crimpdeq/crimpdeq-grips/docs/src/SUMMARY.md

# Summary

[Introduction](introduction.md)

# Photon

- [Fit to your hand](photon/fit.md)
- [Printing](photon/printing.md)
- [Parts](photon/parts.md)
- [Assembly](photon/assembly.md)

# Spark

- [Fit to your hand](spark/fit.md)
- [Printing](spark/printing.md)
- [Parts](spark/parts.md)
- [Assembly](spark/assembly.md)

# Mico

- [Size and cord](mico/size.md)
- [Printing](mico/printing.md)

# Quark

- [Pinches and cord](quark/pinches.md)
- [Printing](quark/printing.md)

# Development

- [Models and checks](development.md)
