crimpdeq/crimpdeq-grips/docs/src/spark/images/end_wall.png

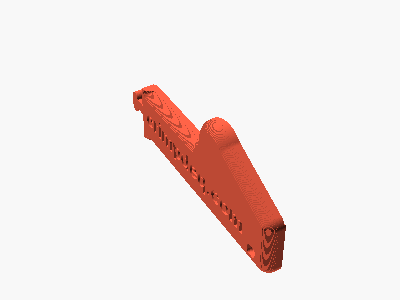
docs/src/spark/images/end_wall.png
