crimpdeq/crimpdeq-grips/docs/src/spark/images/frame.png

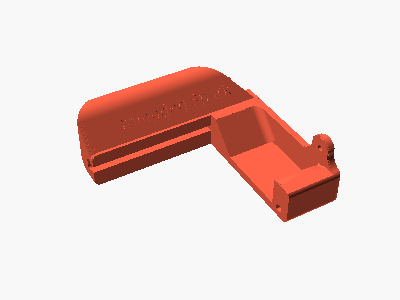
docs/src/spark/images/frame.png
