crimpdeq/crimpdeq-grips/docs/src/spark/images/index_roller.png

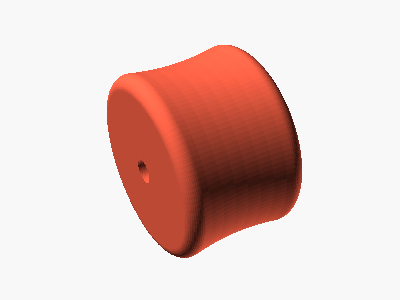
docs/src/spark/images/index_roller.png
