crimpdeq/crimpdeq-grips/docs/src/spark/images/index_wall.png

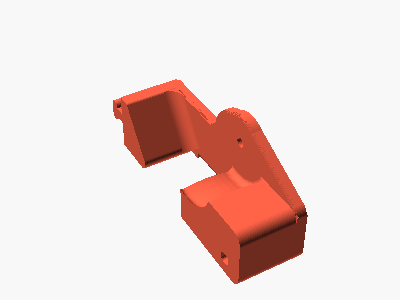
docs/src/spark/images/index_wall.png
