crimpdeq/crimpdeq-grips/docs/src/spark/images/middle_pin.png

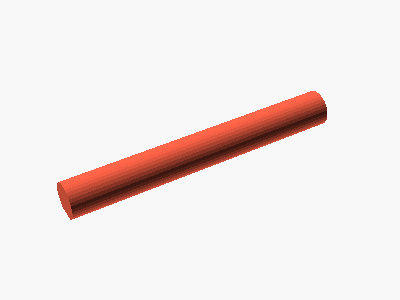
docs/src/spark/images/middle_pin.png
