crimpdeq/crimpdeq-grips/docs/src/spark/images/pinky_roller.png

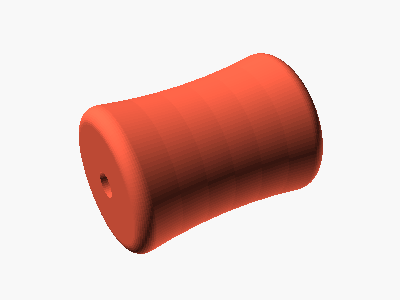
docs/src/spark/images/pinky_roller.png
