crimpdeq/crimpdeq-grips/docs/src/spark/images/ring_wall.png

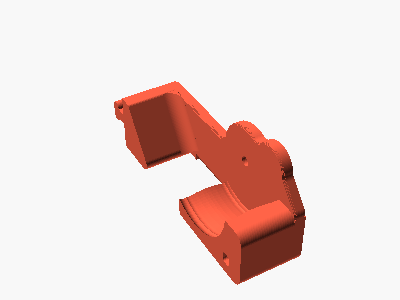
docs/src/spark/images/ring_wall.png
