crimpdeq/crimpdeq-grips/docs/src/photon/parts.md

# Parts

How to put together a printed Photon grip. The pictures show the right-hand grip at the
model's defaults; a left-hand grip is its mirror image and goes together the same way.

You need the 14 printed parts, a cord for the anchor, a mallet or hammer with a small wood block,
and optionally an inert lubricant such as Super Lube.

The middle and index walls look alike: label them as you take them off the plate (the slicer's
object list names every part).

| Part | | How to recognize it |
|---|---|---|
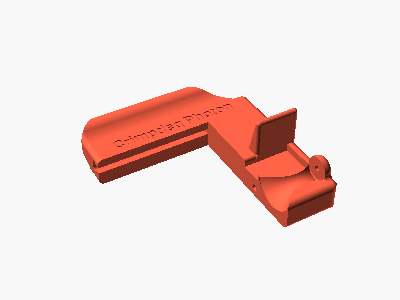
[picture p11: docs/src/photon/images/frame.png]
Frame
| Frame |  | The largest part, with the top crossbar engraved `Crimpdeq Photon` and the cord hole |
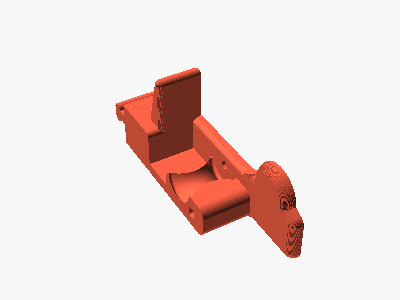
[picture p12: docs/src/photon/images/ring_wall.png]
Ring wall
| Ring wall |  | Round hump around a pin hole |
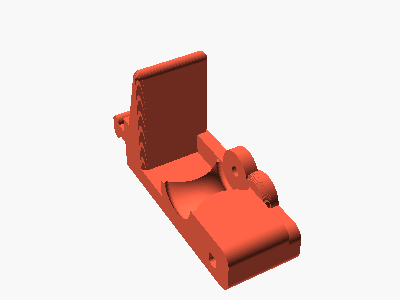
[picture p13: docs/src/photon/images/middle_wall.png]
Middle wall
| Middle wall |  | Looks like the index wall |
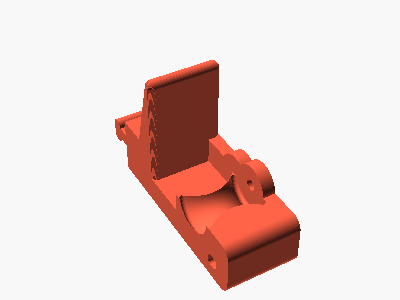
[picture p14: docs/src/photon/images/index_wall.png]
Index wall
| Index wall |  | Looks like the middle wall |
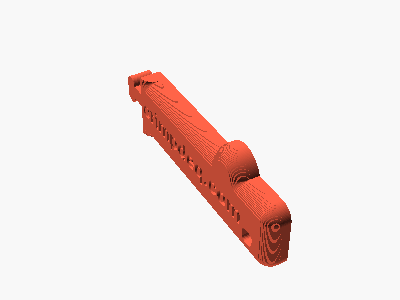
[picture p15: docs/src/photon/images/end_wall.png]
End wall
| End wall |  | Thin plate engraved `crimpdeq.com` |
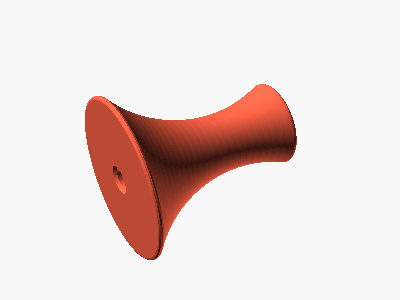
[picture p16: docs/src/photon/images/pinky_roller.png]
Pinky roller
| Pinky roller |  | 30 mm, one narrow and one wide end |
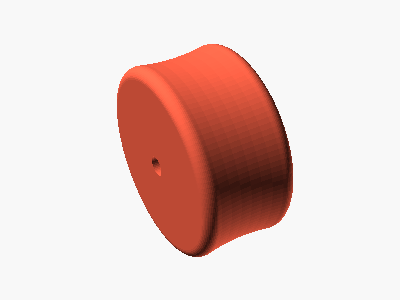
[picture p17: docs/src/spark/images/ring_roller.png]
Roller
| Ring, middle and index rollers (3) |  | 19 mm, both ends the same |
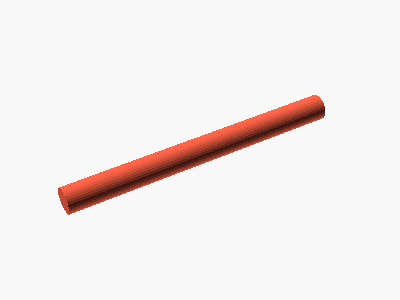
[picture p18: docs/src/photon/images/pinky_pin.png]
Pinky pin
| Pinky pin |  | The longer pin, about 36 mm |
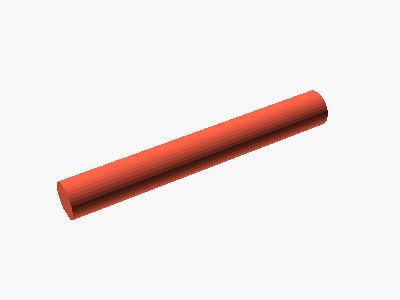
[picture p19: docs/src/photon/images/ring_pin.png]
Pin
| Ring, middle and index pins (3) |  | About 25 mm, interchangeable |
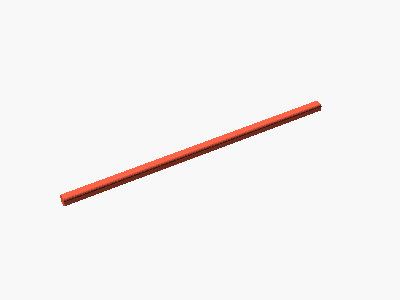
[picture p20: docs/src/spark/images/post.png]
Post
| Post |  | Long square bar, about 105 mm, one corner chamfered |

The illustrations come from the OpenSCAD model; regenerate them with `docs/illustrations/render.sh`.
