crimpdeq/crimpdeq-grips/docs/illustrations/grips.scad

// Both finished grips side by side, Photon on the left, from the STLs of
// ../../scripts/export.py --in-place; render.sh sets stl to their directory, which also holds per
// grip its name engraving's cut (part "name") and its frame without the name: their intersection
// fills the engraving in, in a color of its own.

stl = "/tmp/";

ROLLERS = ["pinky_roller", "ring_roller", "middle_roller", "index_roller"];
BODY = ["frame", "ring_wall", "middle_wall", "index_wall", "end_wall", "pinky_pin", "ring_pin", "middle_pin",
  "index_pin", "post"];

module grip(name) {
  // Near black: pure black hides the shading.
  color([0.16, 0.16, 0.16]) for (p = BODY) import(str(stl, name, "_right_", p, ".stl"));
  color("red") for (p = ROLLERS) import(str(stl, name, "_right_", p, ".stl"));
  color("white") intersection() {
    import(str(stl, name, "_right_name.stl"));
    import(str(stl, name, "_right_unnamed_frame.stl"));
  }
}

grip("photon");
translate([125, 0, 0]) grip("spark");
