crimpdeq/crimpdeq-grips/(list of files, cad)

Other CAD files:
grips/prometheus.scad
grips/spark.scad
docs/illustrations/photon.scad
docs/illustrations/prometheus.scad
