crimpdeq/crimpdeq-grips/docs/src/photon/images/step-4.png

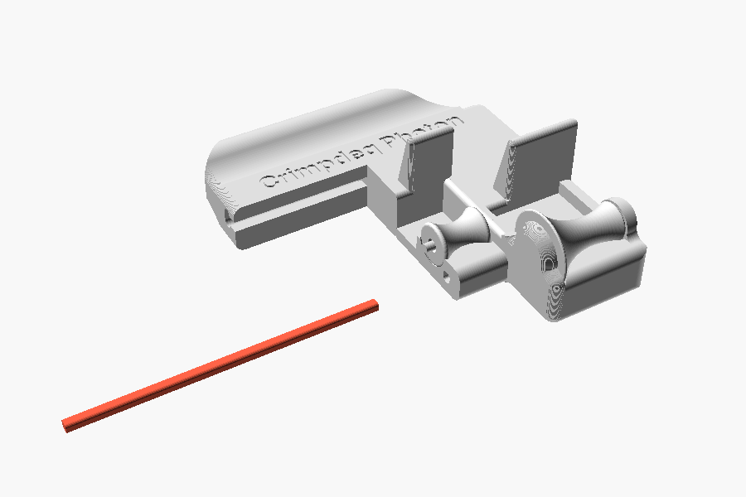
docs/src/photon/images/step-4.png
