crimpdeq/crimpdeq-grips/docs/src/photon/images/step-7.png

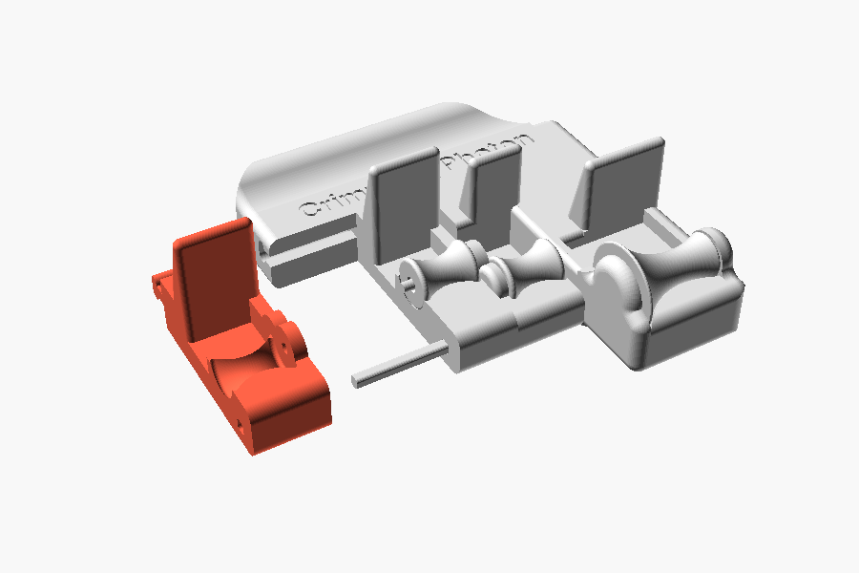
docs/src/photon/images/step-7.png
