crimpdeq/crimpdeq-grips/(commit log)

2026-10-12 feat: add Prometheus hand fitting tools
    prometheus-fit/ measures a hand from a photo (measure-hand.html) and
    generates fitted, print-ready STLs from the original parametric FreeCAD
    model (generate.py), with printed pins sized like the v43 pins. Includes
    a right-hand example with its Bambu Lab A1 project. The root README only
    links to it so the fork's files stay untouched.
2026-10-12 feat: add parametric OpenSCAD model of Prometheus v43
    openscad/prometheus.scad rebuilds every part of the fork's v43 STEP
    (frame, walls, end wall, rollers, printed pins, post and TPU guard)
    from the original FreeCAD VarSet parameters, so measure-hand.html
    output applies unchanged. Each part exports in its print pose, left
    or right hand.
    At v43's blocker positions (the defaults) and frame height, every part
    matches the STEP within 0.3% volume and 0.25 mm at the 99th
    percentile of surface deviation.
2026-10-12 refactor: move shared OpenSCAD building blocks to common.scad
    Extrusion and rounding helpers, pins, post, lock slot and the bore exit
    round move out of prometheus.scad so the Sisyphus model can reuse them.
    Parts are now dispatched from a table, and a blocker reaching the
    crossbar fails with a message instead of breaking the frame.
    All parts still match the v43 STEP as before.
2026-10-12 fix: round OpenSCAD edges without coincident faces
    The rounded end of along_x_rounded now has a core the sharp part ends
    inside, so the two share no faces; thin parts rounded on both faces
    were coming out non-manifold. The bore exit round crosses the faces it
    rounds instead of touching them, which left slivers. Prometheus' anchor
    web joints are rounded as in v43; the round was being overwritten.
2026-10-12 feat: add parametric OpenSCAD model of Sisyphus v27
    openscad/sisyphus.scad rebuilds every part of the fork's Sisyphus v27
    STEP from the original Sisyphus VarSet parameters (heights, seat
    blockers, roller sizes, frame length), exported in print pose for
    either hand. Features the original model lacks (finger stops, anchor,
    guard outline) keep v27's dimensions.
    At the defaults every part matches the STEP within 0.7% volume and,
    except the TPU guard (0.5 mm), 0.1 mm at the 95th percentile.
2026-10-12 feat: add OpenSCAD export and STEP comparison scripts
    export.py writes every part of one hand, optionally from a params.txt
    as measure-hand.html produces it; check_step.py compares each part with
    the STEP solid it rebuilds and fails beyond 1% volume or 0.6 mm at p95.
2026-10-12 docs: document the OpenSCAD models
    openscad/README.md covers use, parameters, printing and how faithful
    the models are; the root and prometheus-fit READMEs link to it and
    AGENTS.md records the model facts and checks for future changes.
2026-10-12 feat: drop the TPU guard from the OpenSCAD models
    Every remaining part prints in one material; the cord through the
    anchor is the only non-printed item. The guard carried no load and the
    anchor's cord exits are already rounded, so the frame works without it.
    The frame's cord switch, which only shaped the guard, goes with it.
2026-10-12 docs: add illustrated Prometheus assembly book
2026-10-12 fix: add a brim to the Prometheus finger walls
2026-10-12 docs: follow the original OpenGrips assembly instructions
2026-10-12 feat: attach Bambu Lab A1 projects to releases
2026-10-13 Download fitted Photon and Spark STLs from the measuring page (#3)
    * perf: round edges with offset layers instead of minkowski()
    minkowski() of non-convex solids needs CGAL, which fails in WebAssembly OpenSCAD and falls back to Nef (13 minutes for one Spark wall). along_x_ball_swept() builds the same ball-swept extrusions from offset profiles in 0.2 mm layers: every part renders in seconds there, native exports get faster, and check_step.py stays within its limits.
    * feat: download fitted Photon and Spark STLs from the measuring page
    The measuring page renders every part with the official WebAssembly OpenSCAD in web workers and downloads a zip per selection: Photon, Spark or both, for one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
2026-10-13 docs: add the Spark chapters and rework the introduction (#6)
    * docs: note that fit chapter is optional for printing the zip
    * docs: add the Spark chapters and rework the introduction
2026-10-20 feat: add Mico, a one-piece mono training loop (#10)
    * feat: add Mico, a one-piece mono training loop
    grips/mico.scad: a 25 mm high loop with a Ø22 finger hole (Hole_Diameter)
    and a cord bore across its flat-ended nose, engraved "Crimpdeq Mico" in
    two arcs on the top face and "crimpdeq.com" around the back, in Inter Bold.
    * feat: release Mico and document it in the book
    export.py exports Mico (mico.stl, no hand), export_bambu_project.py builds
    its A1 project, CI checks its export, and releases attach
    crimpdeq-grips-mico.stl and crimpdeq-grips-mico.3mf. The book gets a Mico
    chapter (size and cord, printing) with a rendered picture, and the README,
    introduction and development page cover i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
2026-10-20 feat: print Mico in PLA with 7 walls by default (#11)
2026-10-20 fix: engrave Mico's name around the back, where it prints readably (#12)
    * fix: engrave Mico's name around the back, where it prints readably
    On the top face, Crimpdeq Mico only fit the nose at size 2.8, and a test
    print closed up its strokes and counters. Both lines now run around the
    back at size 5 (about 1.1 mm strokes), Crimpdeq Mico over crimpdeq.com,
    0.8 mm deep as on Photon and Spark. The model stops with a message if a
    line is too long for the round back.
    * docs: mark Mico's side engraving as untested in print
2026-10-20 feat: add Quark, a one-piece four-pinch block (#13)
    * feat: add Quark, a one-piece four-pinch block
    grips/quark.scad: a hollow profile 90 mm across the heads, extruded 115 mm.
    Two long arms (deep pinches, 62 mm gap) that widen toward their tips and
    two round-headed short arms (shallow pinches, 30 mm gap) sit on either
    side of a hexagonal hub cell, with a stop lug on each side whose ledge
    stops the fingers on the long arms. The cord runs through the head cells.
    Gap, Shallow, Deep and Length are parameters.
    It prints standing on an end face without supports, with 3 mm walls and
    rounded end edges where the cord bends. The long arms' outer faces carry
    wave-shaped grip ridges along the block. "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
2026-11-05 feat: add Slap, a one-piece sloper pump trainer (#15)
    * feat: add Slap, a one-piece sloper pump trainer
    grips/slap.scad: a bent bar 90 mm wide and 16 mm thick, hung from a cord.
    A 60 mm cord arm turns through a 55 degree bend (36 mm sloper radius)
    into a 62 mm gripped arm. A slot across the cord arm has five notches
    that set the hanging angle. Width and Bend_Angle are parameters.
    It prints standing on an end face without supports; the slot is a
    vertical hole and its ends are rounded where the cord bends. "Crimpdeq
    Slap" over "crimpdeq.com" is engraved on the gripped arm's inner face.
    * feat: release Slap and document it in the book
    export.py exports Slap like Mico and Quark (ONE_PIECE, s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
